ytmytm/c64-ds12c887/schematic/README

Maciej 'YTM/Elysium' Witkowiak <ytm@elysium.pl>
07.09.2002

This is schematic file for interfacing DS12C887 Real Time Clock chip with
C64/128 computer.

Source schematic is in gEDA format.
