ytmytm/c64-ds12c887/schematic/ds12c887-c64.pdf

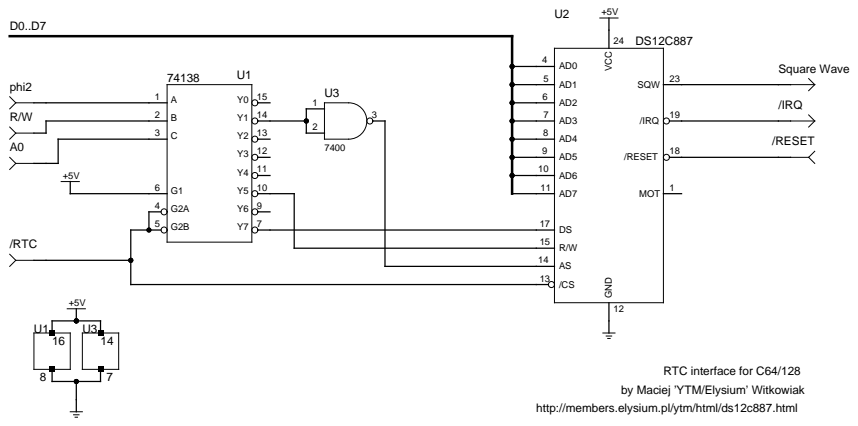
[picture p5: page 1]
23 SQW; 19 /IRQ; 18 /RESET; 1 MOT; VCC; GND; phi2; /RESET; /IRQ; Square Wave; /RTC

RTC interface for C64/128

by Maciej ’YTM/Elysium’ Witkowiak

http://members.elysium.pl/ytm/html/ds12c887.html
